xiaoshecode/DDS49957/docs/maintenance.md

# 维护与验证记录

检查日期：2026-10-30。范围：默认分支中的工程结构、3 个手写 Verilog 源、HDL 模块依赖与元数据。

- `profile_sync`：缓存统一为 3 位，与输入和输出一致，消除静默扩展/截断告警；保留既有时钟边沿和数据流。
- `Digi_ATT`：存在无复位接口的状态机和带符号常量比较告警；默认分支可以恢复非法状态，但上电和硬件行为需要仿真确认。
- `pll_config_mcu`：数据输出只在复位时赋零；发送计数/使能逻辑缺少完整协议和寄存器表，暂不猜测补全。
- BD module reference 需要恢复原始 `uart` / `SPI_Master` 源与关联 IP；没有完整 `.xpr`、自动重建 Tcl 或测试平台。

## 已执行

使用 pyslang 12.1.0 对 `sources_1/code_save/*.v` 做解析和编译展开，0 个 error；剩余告警主要来自 `Digi_ATT` 的状态常量类型和多余分号。该工具不验证 VHDL、Xilinx IP 或板级时序。

## 后续验证

恢复 Vivado 工程后，必须补充 UART/SPI testbench、跨时钟域检查、约束完整性和时序收敛记录。未执行综合、实现或硬件下载。保留现有器件配置和文件路径，不以目录美化替代设计验证。
