xiaoshecode/DDS49957/K7_DDS_AD9957_1109_1.pdf

DRAWN:

## WangBo

DATED:
2023.11.03

# IIIS

# K7DDS

B

SHEET: | OF | 40


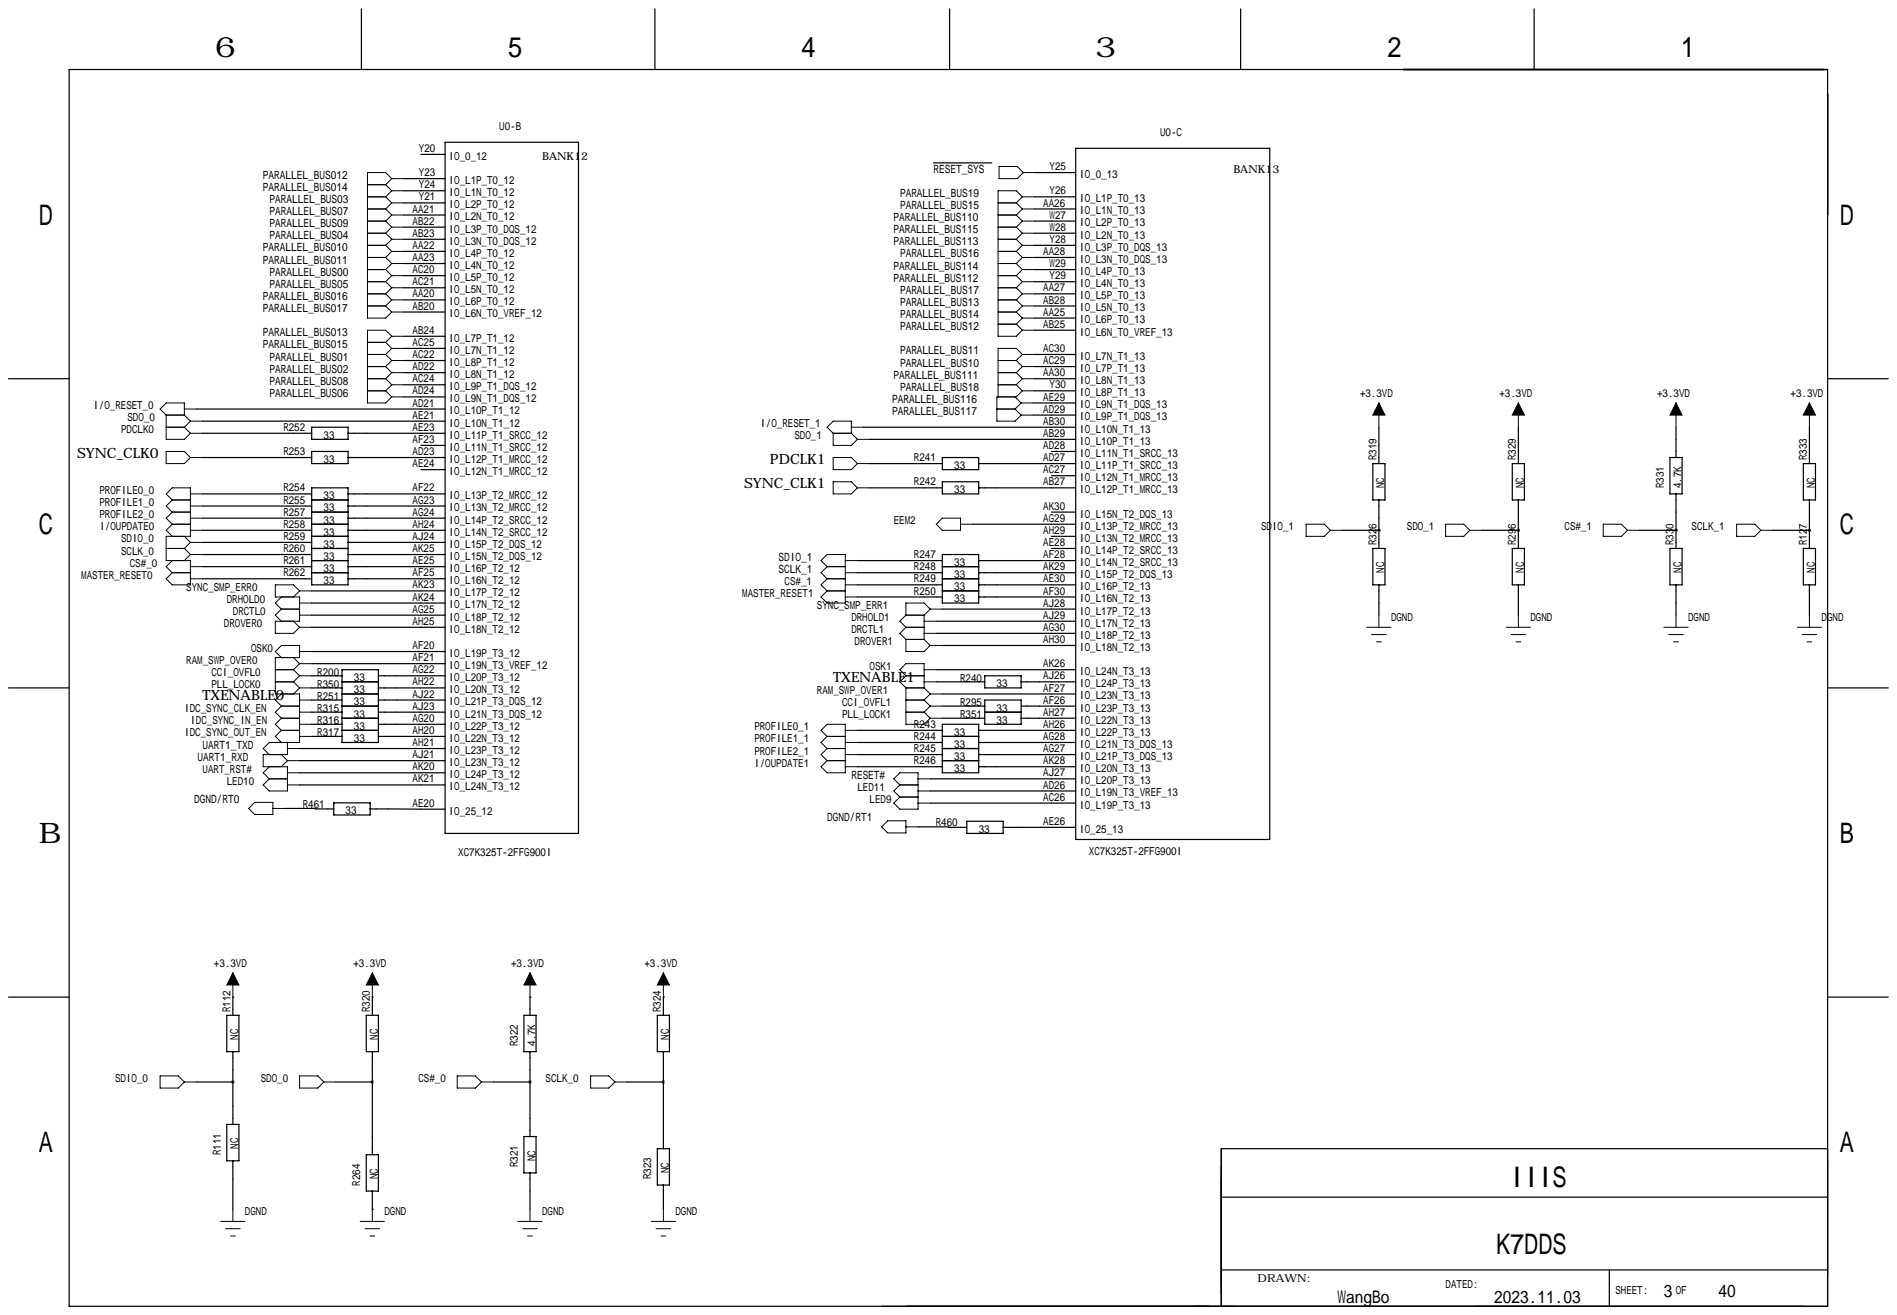
[picture p41: page 3]

## 3.3V bank

## 3.3V bank

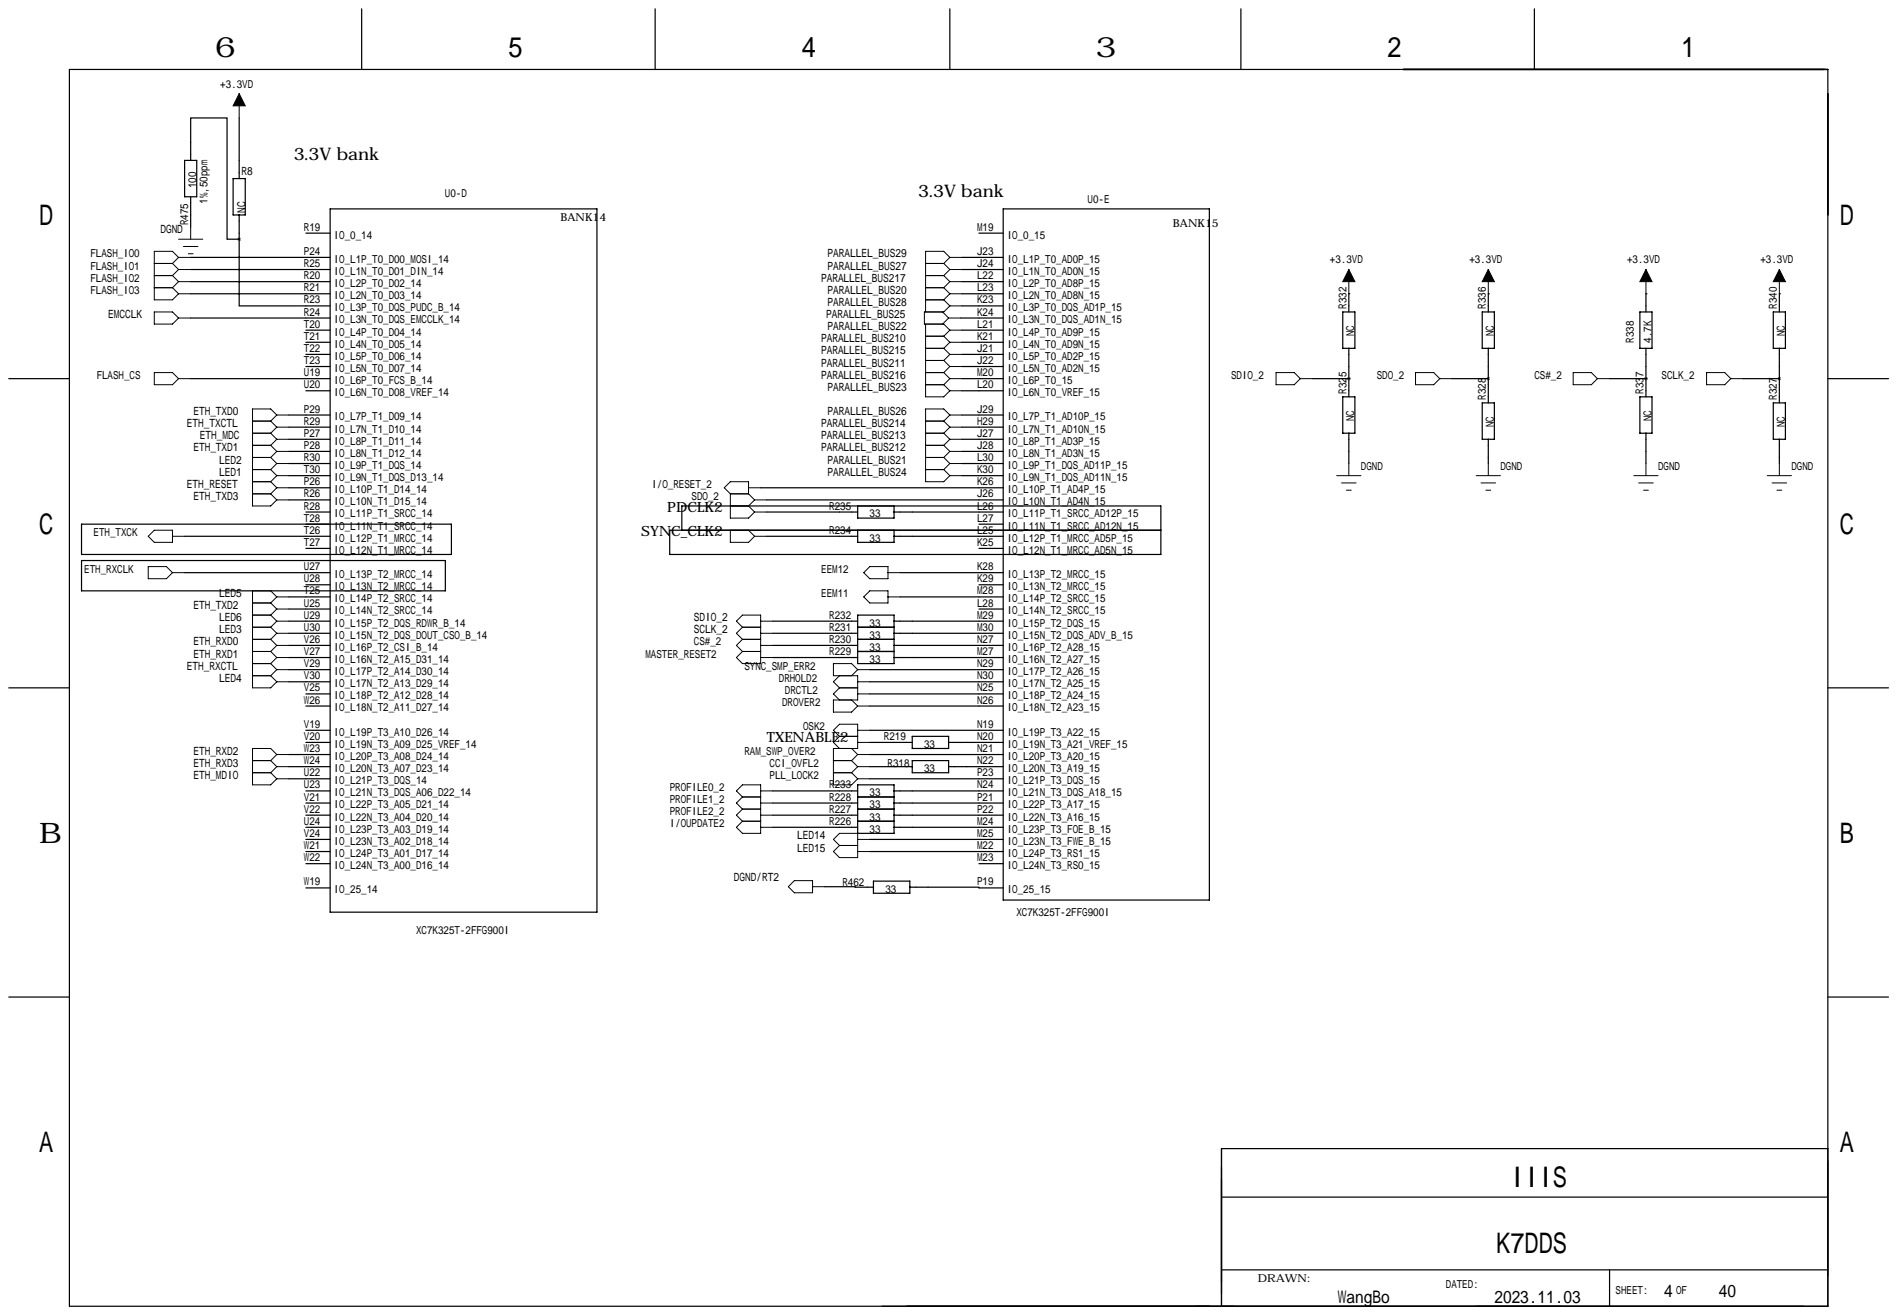
[picture p42: page 4]

IO_L11P_T1_SRCC_AD12P_15 IO_L11N_T1_SRCC_AD12N_15

IO_L12P_T1_MRCC_AD5P_15 IO_L12N_T1_MRCC_AD5N_15

## 3.3V bank

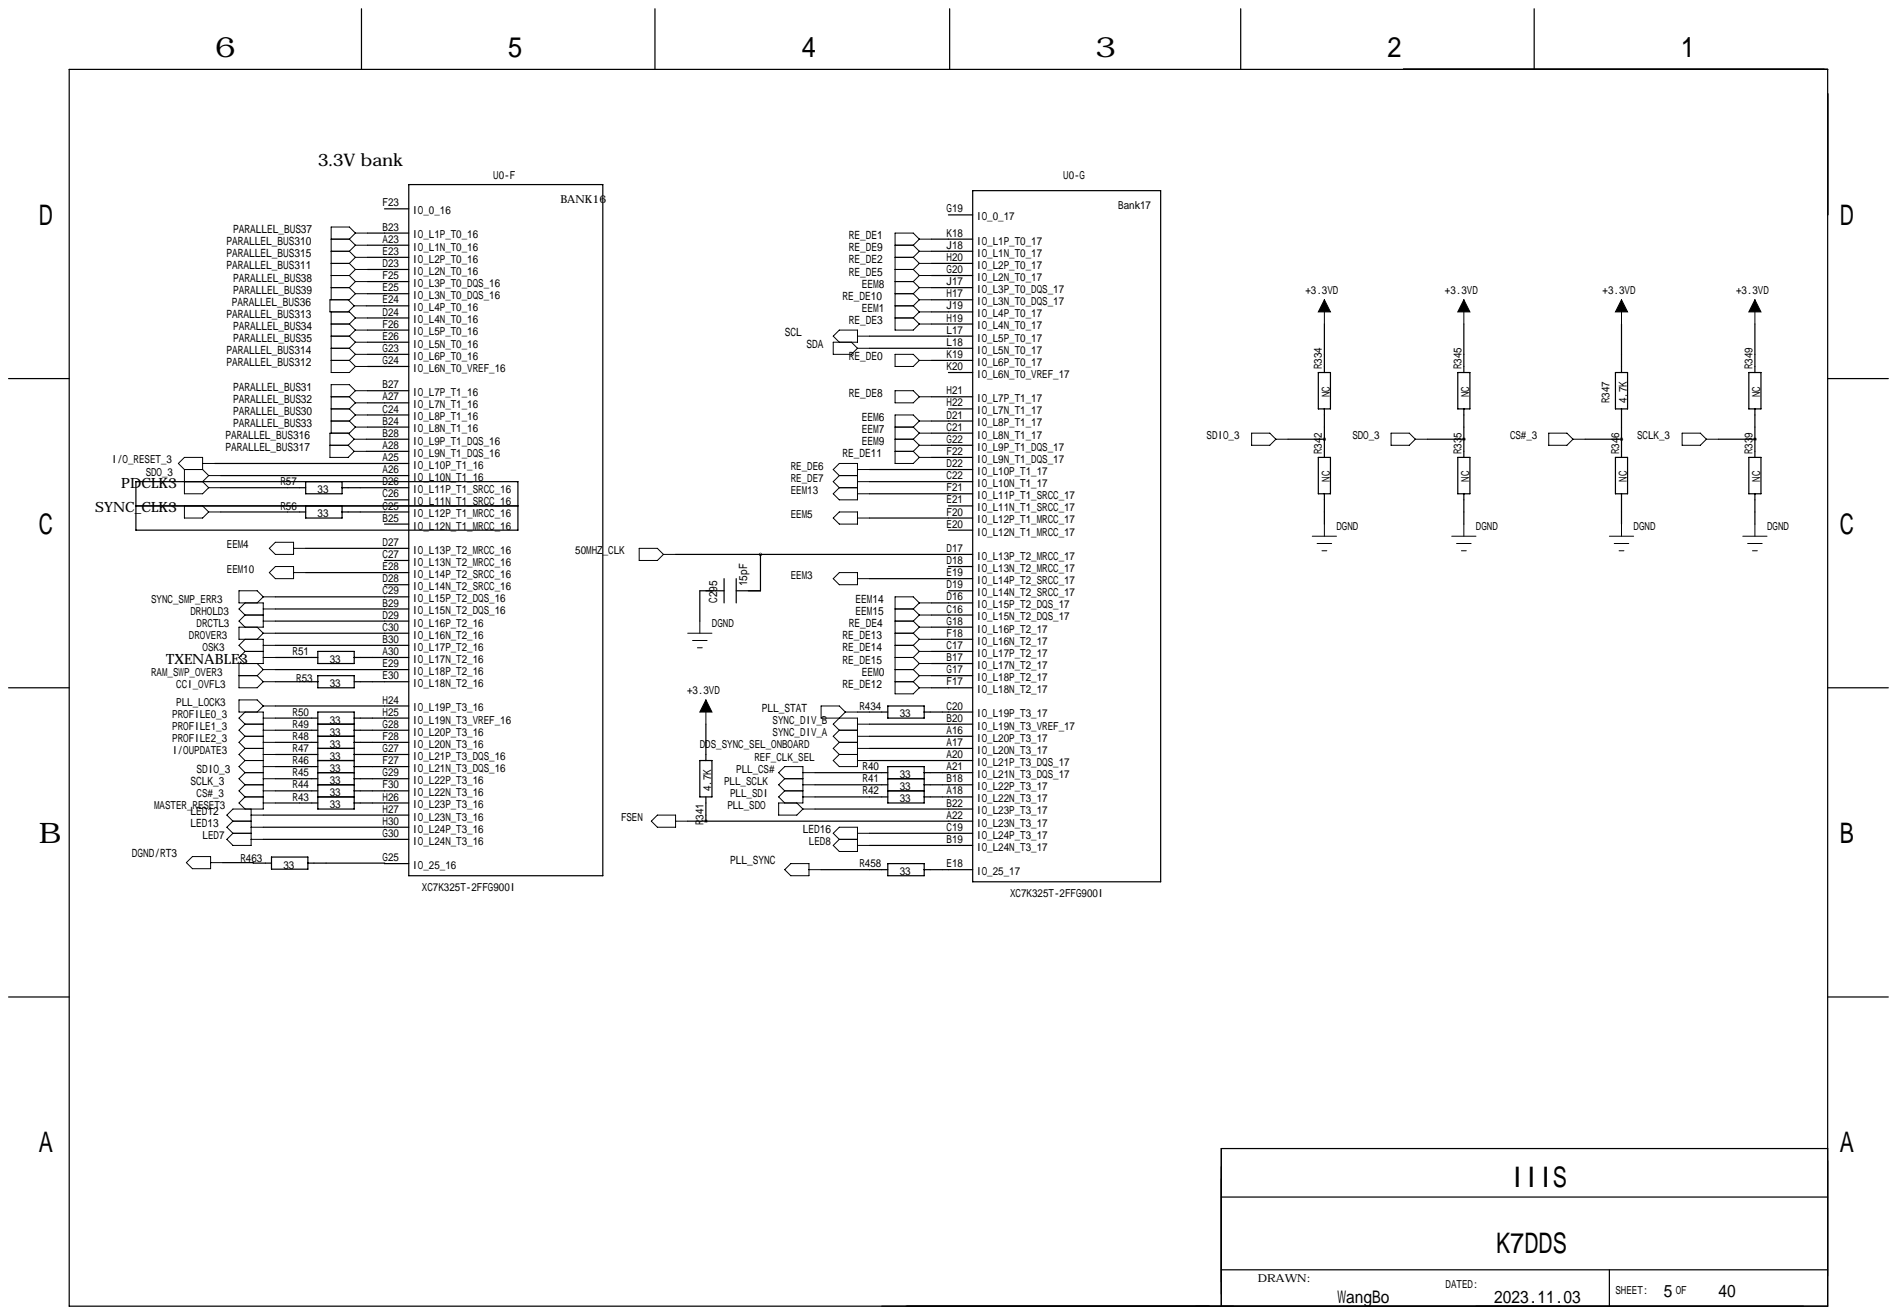
[picture p43: page 5]

G12 | BANK18


SHEET:; K7DDS; IIIS; IO_0_VRN_33; IO_L3P_T0_DQS_33; IO_L3N_T0_DQS_33; IO_L6N_T0_VREF_33; IO_L9P_T1_DQS_33; IO_L9N_T1_DQS_33; IO_L11P_T1_SRCC_33; IO_L11N_T1_SRCC_33; IO_L12P_T1_MRCC_33; IO_L12N_T1_MRCC_33; IO_L13P_T2_MRCC_33; IO_L13N_T2_MRCC_33; IO_L14P_T2_SRCC_33; IO_L14N_T2_SRCC_33; IO_L15P_T2_DQS_33; IO_L15N_T2_DQS_33; IO_L19N_T3_VREF_33; IO_L21P_T3_DQS_33; IO_L21N_T3_DQS_33; IO_25_VRP_33; XC7K325T-2FFG900I; BANK34; IO_0_VRN_34; IO_L3P_T0_DQS_34; IO_L3N_T0_DQS_34; IO_L6N_T0_VREF_34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

SHEET:; K7DDS; IIIS; MGTXTXP3_115; MGTXRXP3_115; MGTXTXN3_115; MGTXRXN3_115; MGTXTXP2_115; MGTXRXP2_115; MGTXTXN2_115; MGTREFCLK0P_115; MGTXRXN2_115; MGTAVTTRCAL_115; MGTREFCLK0N_115; MGTRREF_115; MGTREFCLK1N_115; MGTREFCLK1P_115; MGTXTXP1_115; MGTXRXP1_115; MGTXTXN1_115; MGTXRXN1_115; MGTXTXP0_115; MGTXRXP0_115; MGTXTXN0_115; MGTXRXN0_115; XC7K325T-2FFG900I; MGTXTXP3_116; MGTXRXP3_116; MGTXTXN3_116; MGTXRXN3_116; MGTXTXP2_116; MGTXRXP2_116; MGTXTXN2_116; MGTREFCLK0P_116; MGTXRXN2_116; MGTREFCLK0N_116; MGTREFCLK1N_116; MGTREFCLK1P_116; MGTXTXP1_116; MGTXRXP1_116; MGTXTXN1_116; MGTXRXN1_116; MGTXTXP0_116; MGTXRXP0_116; MGTXTXN0_116; MGTXRXN0_116; MGTXTXP3_117; MGTXRXP3_117; MGTXTXN3_117; MGTXRXN3_117; MGTXTXP2_117; MGTXRXP2_117; MGTXTXN2_117; MGTREFCLK0P_117; MGTXRXN2_117; MGTREFCLK0N_117; MGTREFCLK1N_117; MGTREFCLK1P_117; MGTXTXP1_117; MGTXRXP1_117; MGTXTXN1_117; MGTXRXN1_117; MGTXTXP0_117; MGTXRXP0_117; MGTXTXN0_117; MGTXRXN0_117; MGTXTXP3_118; MGTXRXP3_118; MGTXTXN3_118; MGTXRXN3_118; MGTXTXP2_118; MGTXRXP2_118; MGTXTXN2_118; MGTREFCLK0P_118; MGTXRXN2_118; MGTREFCLK0N_118; MGTREFCLK1N_118; MGTREFCLK1P_118; MGTXTXP1_118; MGTXRXP1_118; MGTXTXN1_118; MGTXRXN1_118; MGTXTXP0_118; MGTXRXP0_118; MGTXTXN0_118; MGTXRXN0_118

VCCINT，VCCBRAM->VCCAUX，VCC_AUXIO->VCCO


SHEET:; K7DDS; IIIS; DQ0 DQ1 DQ2/WP DQ3/HOLD; CLK; VCC; GND; PAD; MT25QL256ABA1EW9; DGND; FLASH_IO0 FLASH_IO1 FLASH_IO2 FLASH_IO3; FLASH_CLK; FLASH_CS



# AD9957 63,62:DGND; 61:NC; 51:RT; 43,42:data;24:NC;20:CCI_OVFL

## 额定电流530mA

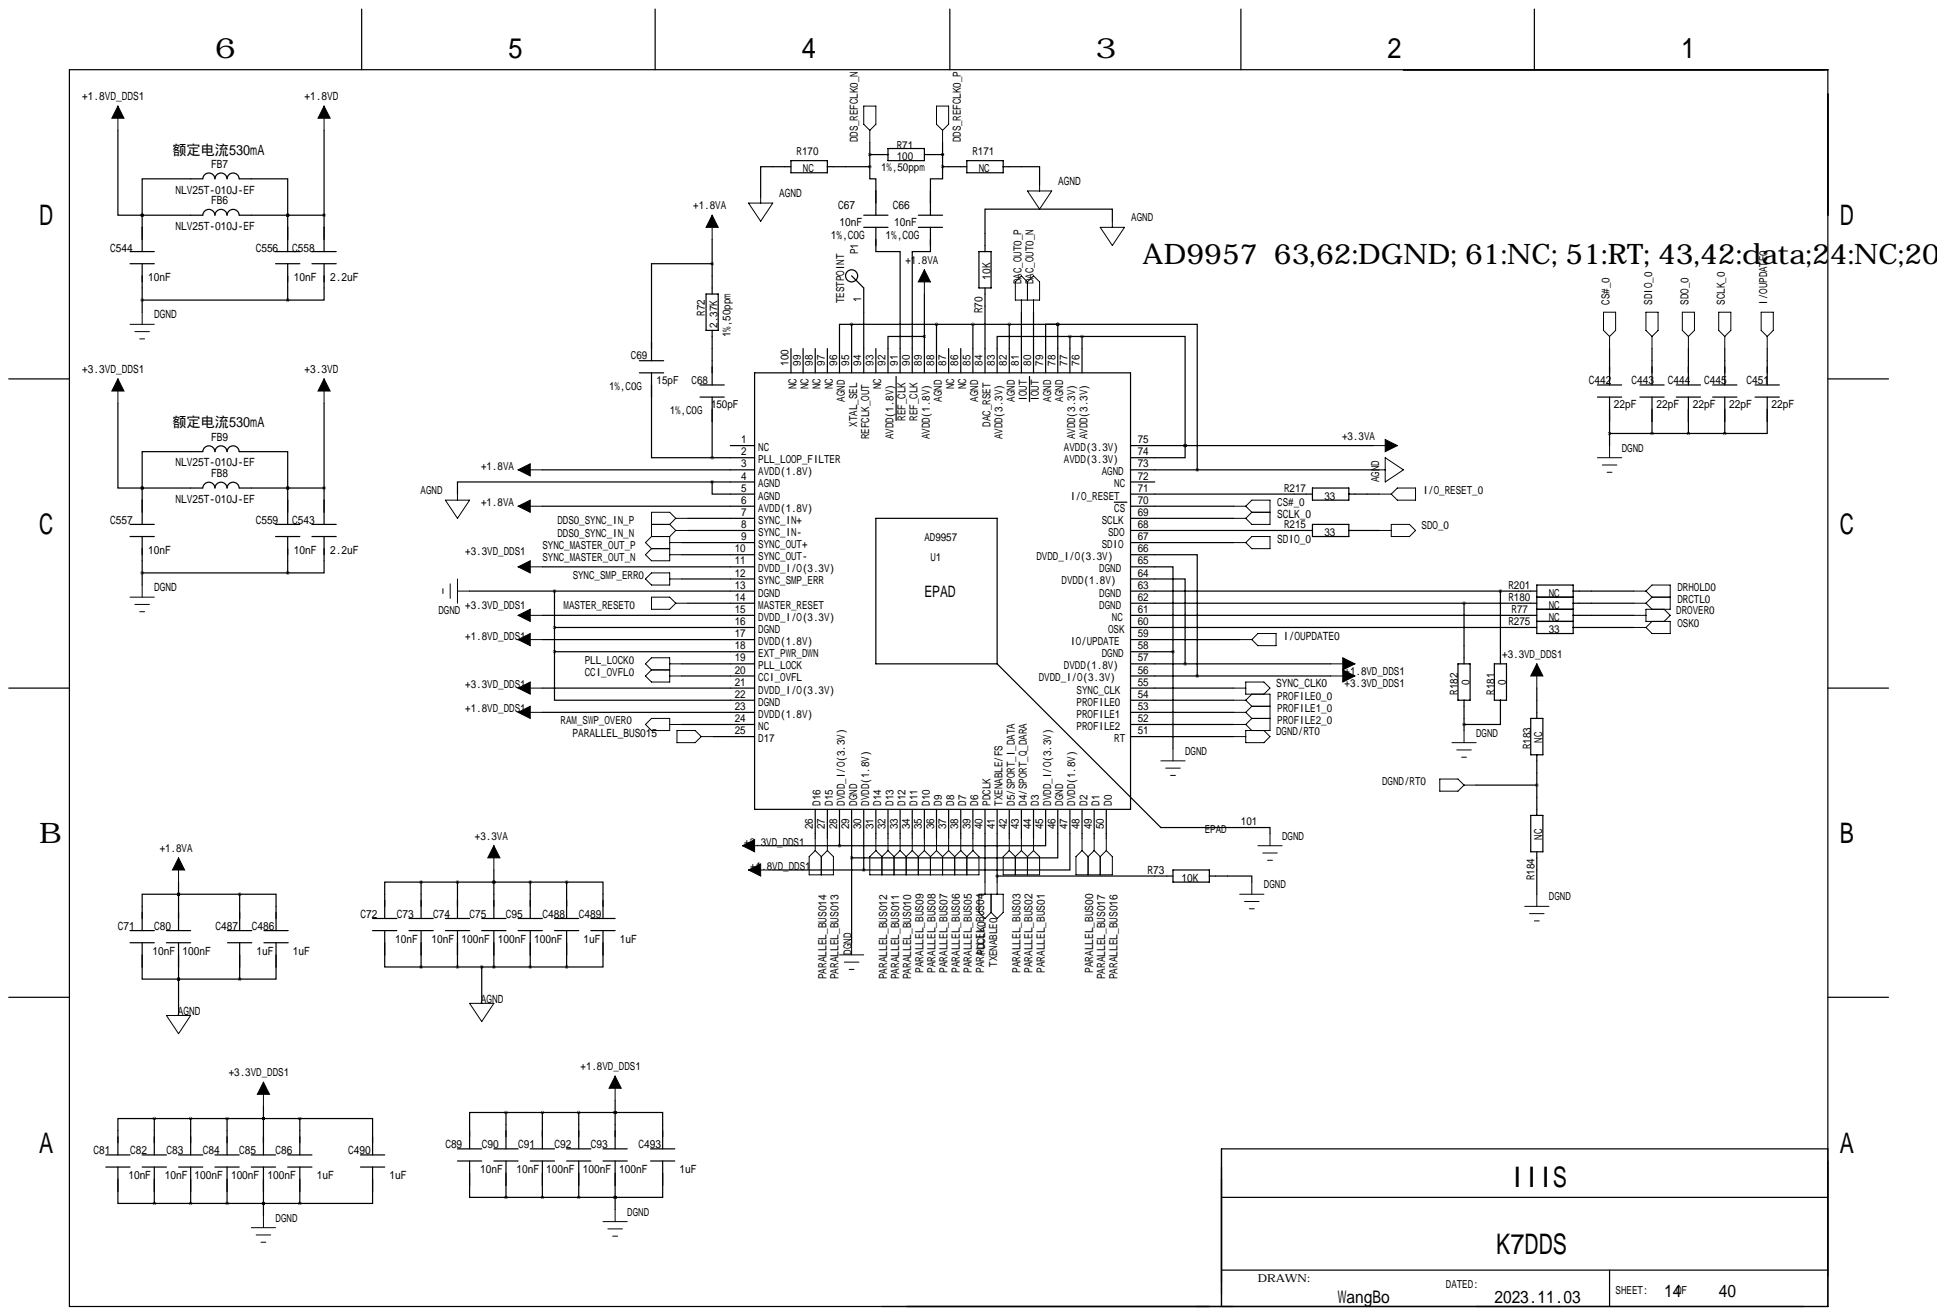
[picture p44: page 14]

额定电流530mA | CML模式，仅用于匹配

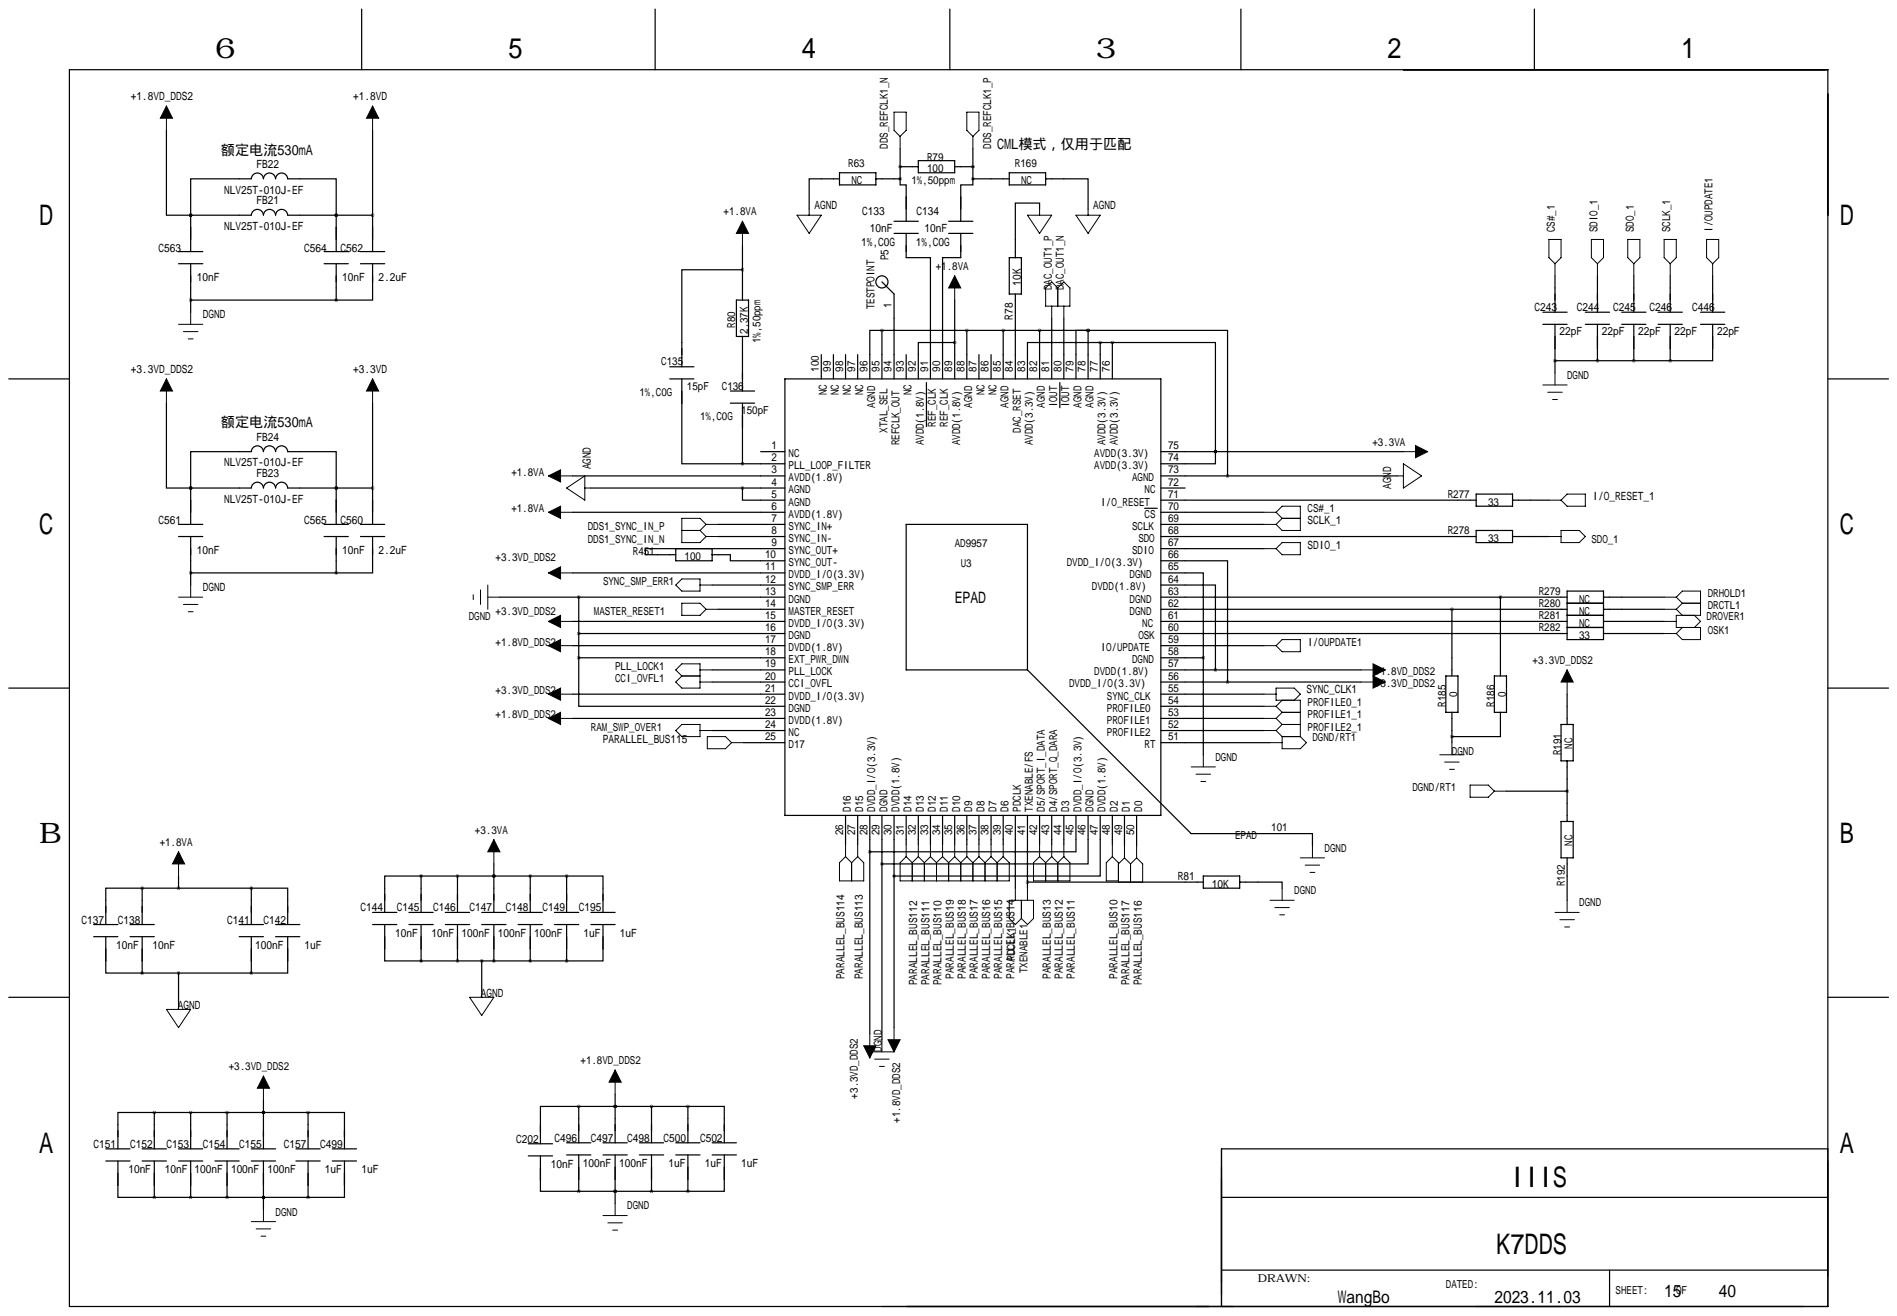
[picture p45: page 15]

## 额定电流530mA

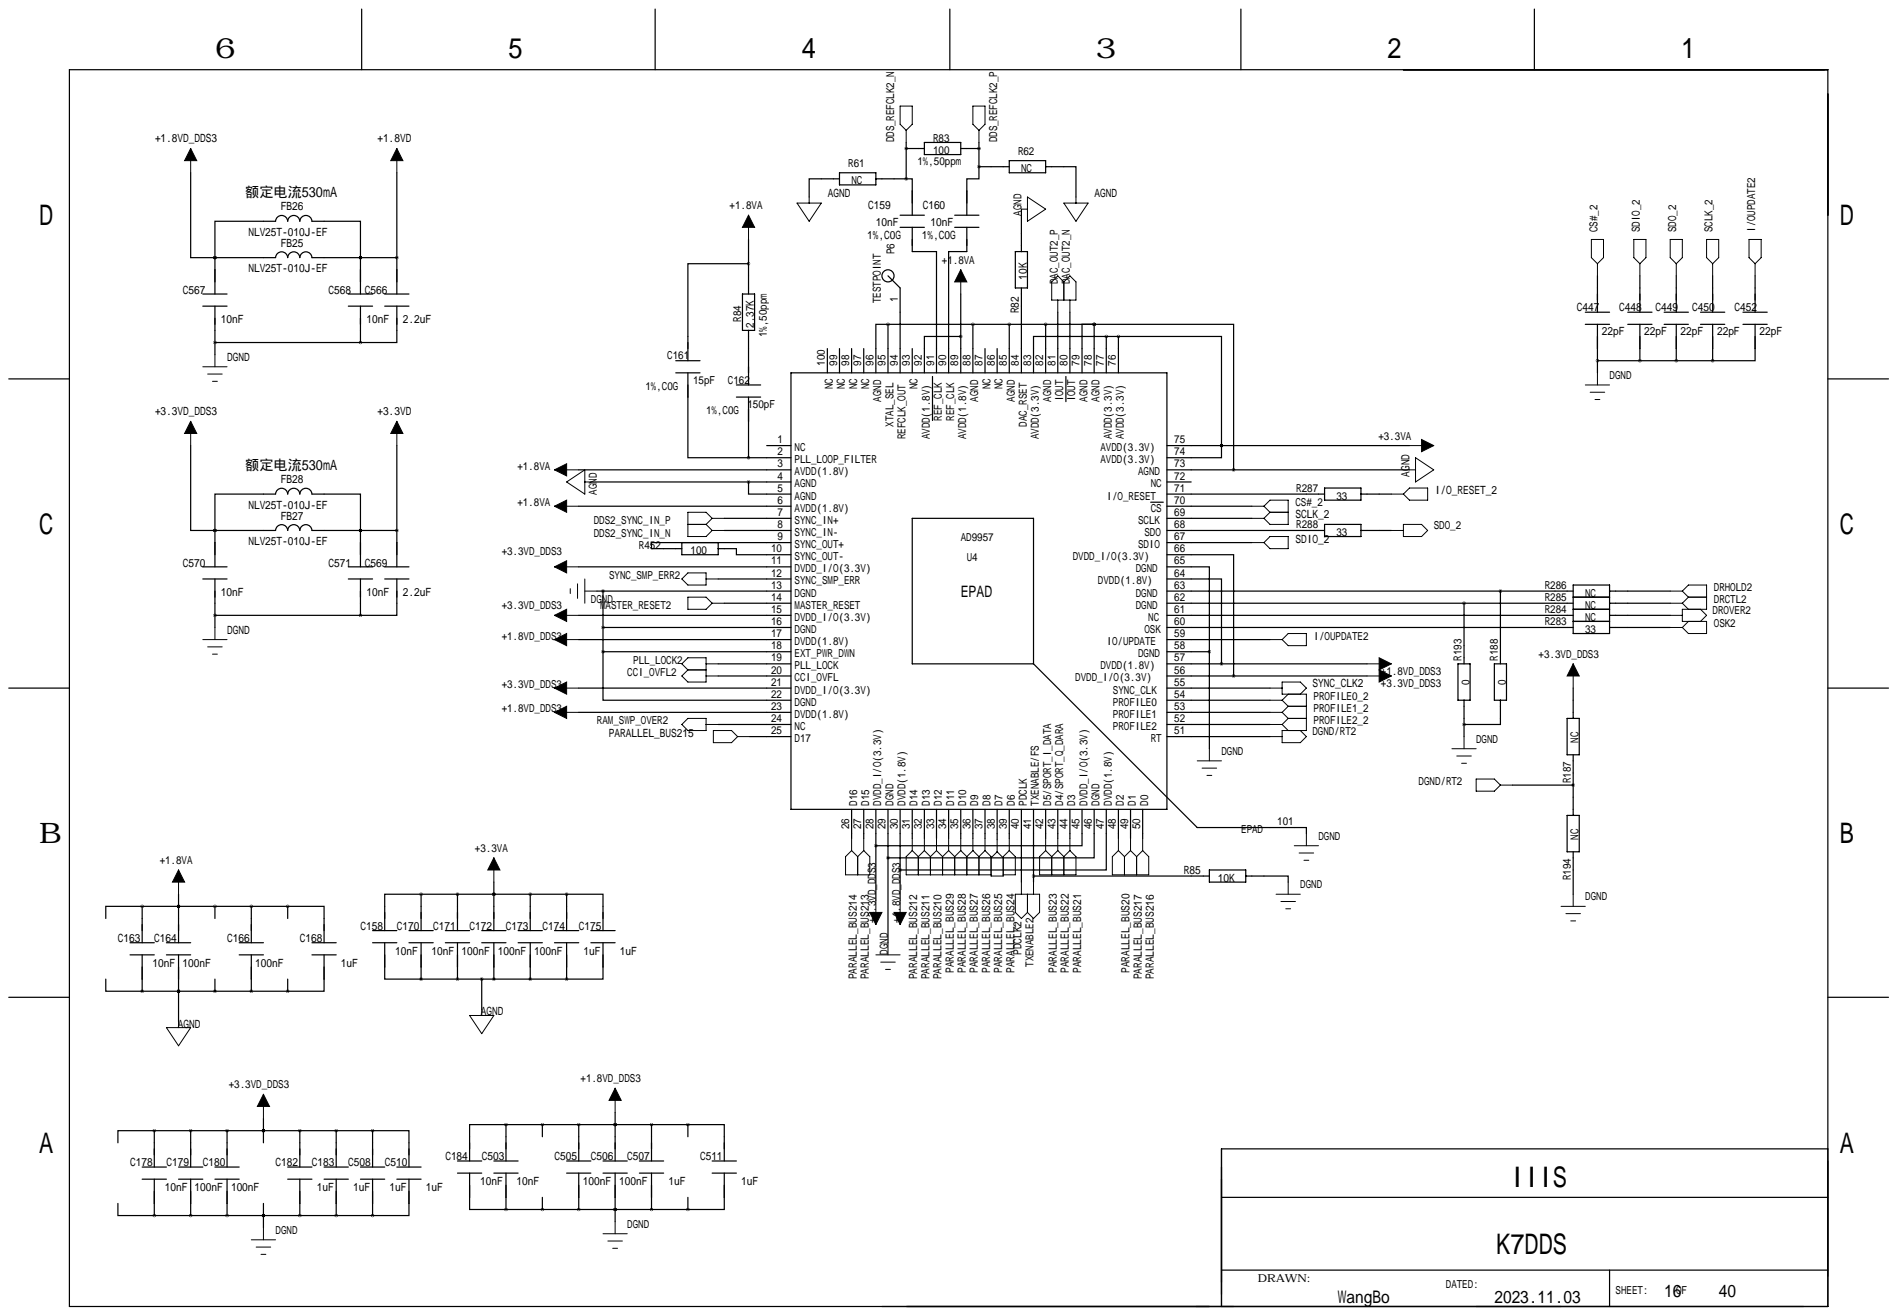
[picture p46: page 16]

## 额定电流530mA

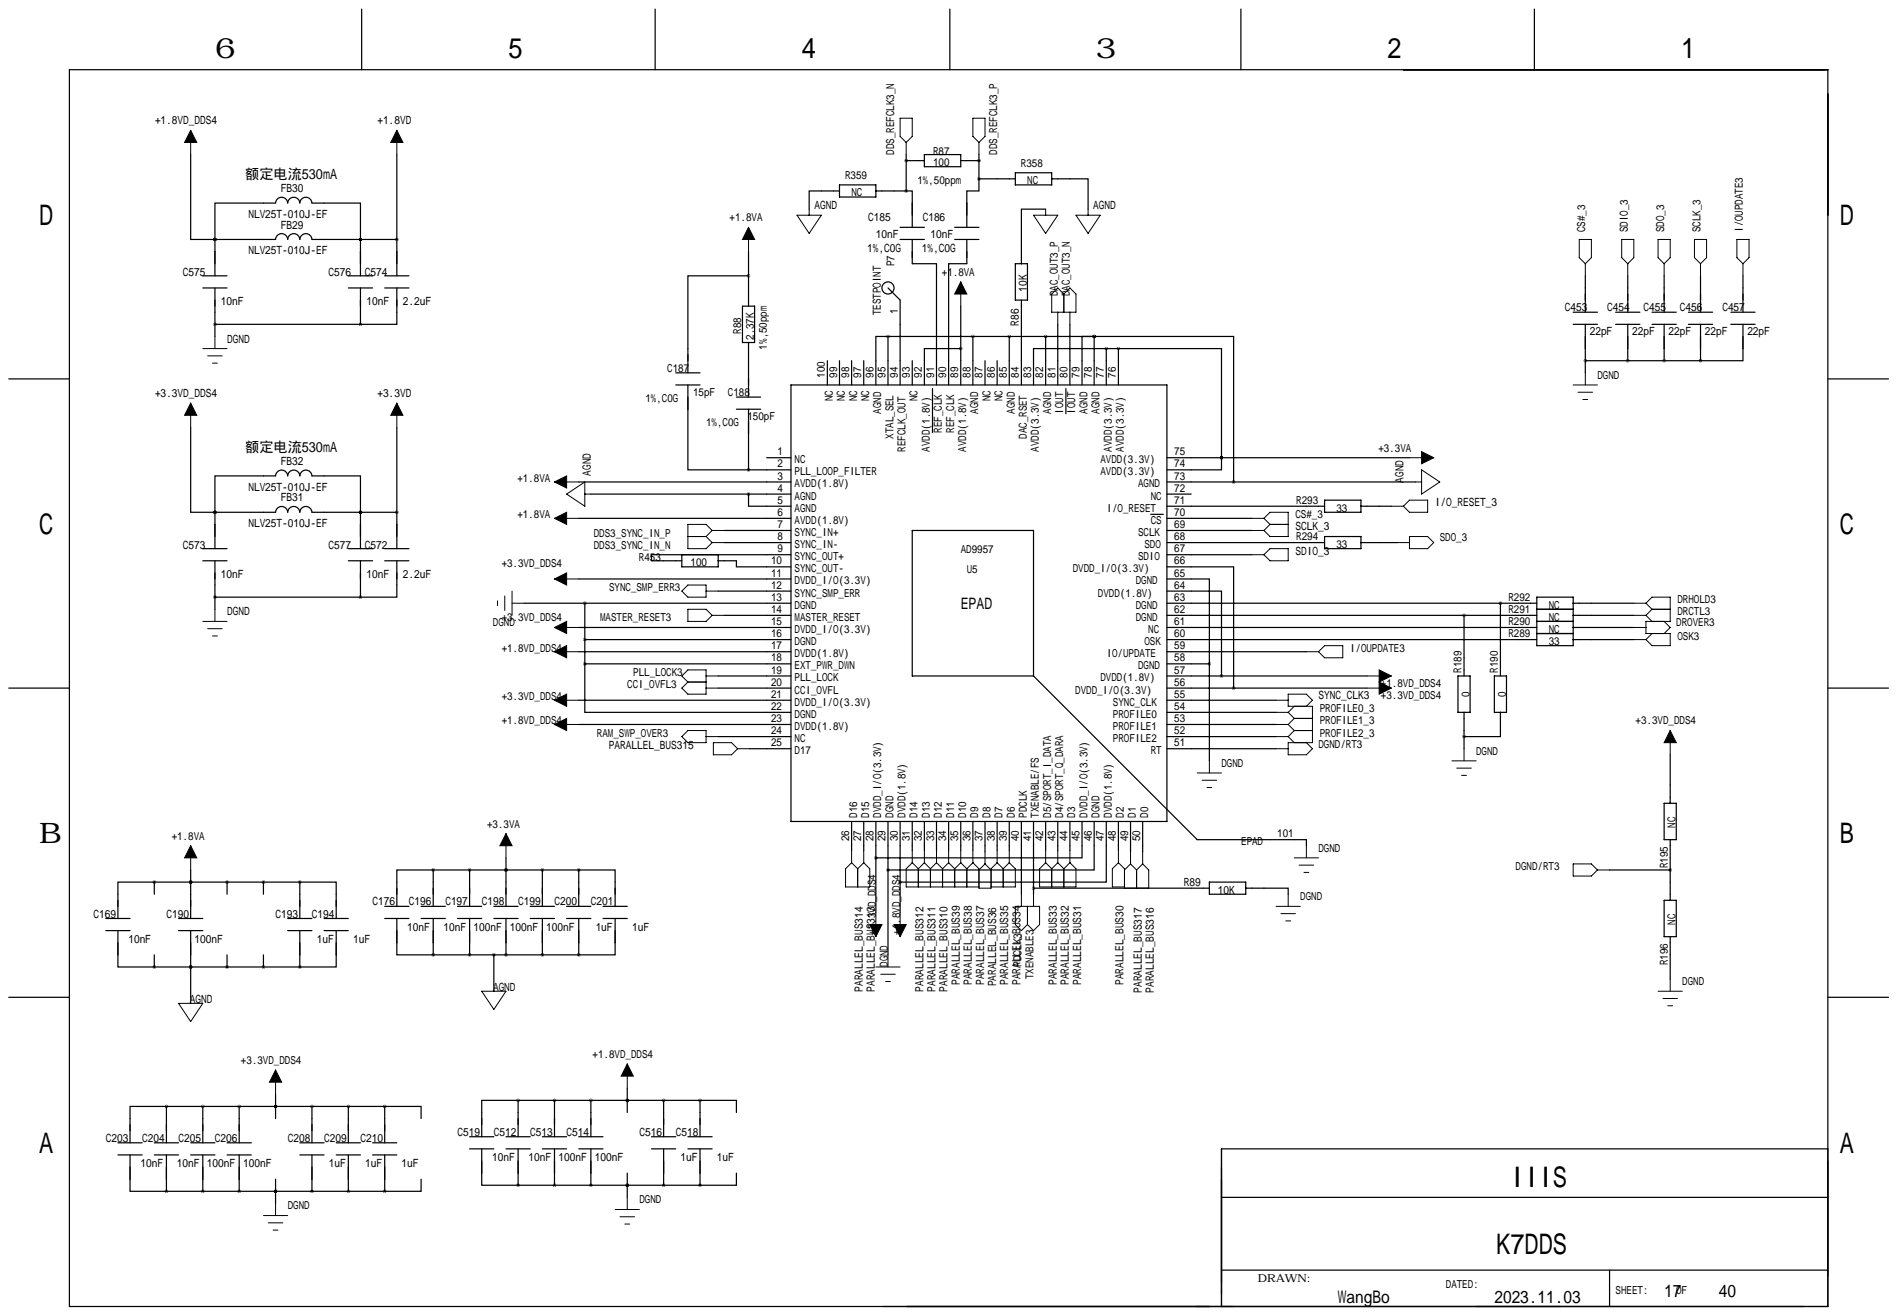
[picture p47: page 17]





## diff swing 400mV~980mV


## AD9910内部有100欧姆电阻


44 | 39
34 | 45



REF+ | CP

22
30

OUT4+ OUT4- | 14


IIIS; K7DDS; SHEET:; Address is 000; VDD; GND; SDA SCL; OS/ALERT; NCT75DR2G; DGND; NCT75_A0 NCT75_A1 NCT75_A2

IIIS; K7DDS; SHEET:; VSS; VCC NC SCL SDA; 24AA02E48_SOT; DGND; SCL SDA

## Pull-up resistance are on the sensor schematic

靠近pin11，pin40 | 靠近pin29 靠近pin28 | 靠近pin21


+3.3VD_PHY


## 额定电流530mA



## 程序加载完成后FPGA_DONE输出高电平（上升沿），延时（max750ns）后，输出140~280ms的reset信号负脉冲 提供加载程序后的第一次复位



19 | 12
20 | 13


L3




2A

L9


# 风扇电源

500mA

IIIS; K7DDS; SHEET:; 散热板安装孔,直径4mm; 固定安装孔; FPGA 31mmx31mm; 模拟区安装孔; SMD0805P050TF/12; HOLE_4MM; HOLE_M3; HOLE_2R7MM; HOLE_M2; DGND; AGND
